DaGromflomite/squachwatch-cyd-case/SquachWatch_Release_v20/squachwatch_case_v20.3mf

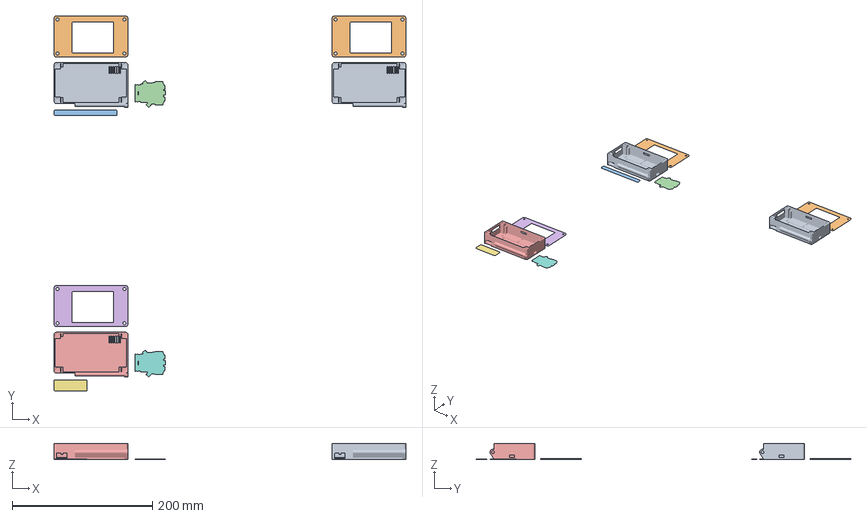
[picture p1: CAD file, 2026-10-18]
SquachWatch_Release_v20/squachwatch_case_v20.3mf
501.0 x 534.1 x 23.0 mm
P1_Horizontal_back_shell
P1_Horizontal_bezel
P1_Horizontal_wordmark_badge
P1_Horizontal_logo_badge
P3_Vertical_back_shell
P3_Vertical_bezel
P3_Vertical_wordmark_badge
P3_Vertical_logo_badge
P2_Plain_back_shell
P2_Plain_bezel
